NicolasTum/Tesis-Sistema-Aut-nomo-de-monitoreo-y-an-lisis-de-alarmas-para-radiobases/Análisis de datos/README.txt

Utilizar Visual Studio o similar, ejecutar en el siguiente orden:
1 - agrupar_alarmas_py
2 - analizar_alarmas.py
3 - analisis_avanzado.py
4 - detectar_eventos_compuestos.py

Los datos deben estar en data y las reglas en rules. En cambio de tener otros nombres para los archivos será necesario modificarlos en los scripts.
