NicolasTum/Tesis-Sistema-Aut-nomo-de-monitoreo-y-an-lisis-de-alarmas-para-radiobases/(threads)

Thread 2 (2025-08-04):

Envío cada una hora y cambios de estado

NicolasTum, 2025-08-04:
#include <WiFi.h>
#include <PubSubClient.h>
#include <ArduinoJson.h>
#include "NicoModBus.h"

// WiFi
const char* ssid = "HugoPacoY";
const char* password = "32950002";

// ThingsBoard
const char* tb_server = "demo.thingsboard.io";
const int tb_port = 1883;
const char* tb_token = "2dkwSGsuUQYaMfpJPUGB";

WiFiClient wifiClient;
PubSubClient mqttClient(wifiClient);

// Modbus
IPAddress moxaIP(192, 168, 1, 150);
NicoModBus mb;
bool diStates[12];
bool lastDiStates[12]; // Para comparar cambios
unsigned long lastHourlySend = 0;
const unsigned long hourlyInterval = 3600000; // 1 hora en milisegundos

void reconnectMQTT() {
  while (!mqttClient.connected()) {
    Serial.print("🔄 Conectando a ThingsBoard...");
    if (mqttClient.connect("ESP32Cliente", tb_token, NULL)) {
      Serial.println("✅ Conectado a ThingsBoard MQTT");
    } else {
      Serial.print("❌ Error MQTT: ");
      Serial.println(mqttClient.state());
      delay(2000);
    }
  }
}

void sendToThingsBoard() {
  // Armar JSON para ThingsBoard
  DynamicJsonDocument json(512);
  for (int i = 0; i < 12; i++) {
    String key = "DI" + String(i);
    json[key] = diStates[i];
  }

  char payload[256];
  serializeJson(json, payload);

  // Publicar a ThingsBoard
  if (mqttClient.publish("v1/devices/me/telemetry", payload)) {
    Serial.println("📤 Payload enviado:");
    Serial.println(payload);

    // Actualizar últimos estados enviados
    memcpy(lastDiStates, diStates, sizeof(diStates));
  } else {
    Serial.println("❌ Falló el envío a ThingsBoard");
  }
}

bool checkStateChanges() {
  for (int i = 0; i < 12; i++) {
    if (diStates[i] != lastDiStates[i]) {
      return true; // Hay cambios
    }
  }
  return false; // No hay cambios
}

void setup() {
  Serial.begin(115200);

  WiFi.begin(ssid, password);
  Serial.print("Conectando a WiFi...");
  while (WiFi.status() != WL_CONNECTED) {
    delay(500);
    Serial.print(".");
  }
  Serial.println("\n✅ WiFi conectado");

  mqttClient.setServer(tb_server, tb_port);

  // Conexión Modbus
  if (!mb.connect(moxaIP)) {
    Serial.println("❌ Falló conexión Modbus");
    while (true) delay(500);
  }

  // Inicializar últimos estados
  memset(lastDiStates, 0, sizeof(lastDiStates));
}

void loop() {
  if (!mqttClient.connected()) {
    reconnectMQTT();
  }
  mqttClient.loop();

  if (mb.readDiscreteInputs(0, diStates, 12)) {
    bool stateChanged = checkStateChanges();
    unsigned long currentMillis = millis();

    // Enviar si hay cambios o si ha pasado una hora
    if (stateChanged || (currentMillis - lastHourlySend >= hourlyInterval)) {
      sendToThingsBoard();

      if (stateChanged) {
        Serial.println("🔄 Cambio de estado detectado");
      } else {
        Serial.println("⏰ Envío periódico cada hora");
      }

      lastHourlySend = currentMillis;
    }
  } else {
    Serial.println("❌ Falló lectura Modbus, intentando reconexión...");
    mb.disconnect();
    delay(1000);
    mb.connect(moxaIP);
  }

  delay(100); // Pequeño delay para evitar saturación
}

Thread 5 (2025-09-16):

Sensors final

NicolasTum, 2025-09-16:
#include <WiFi.h>
#include <PubSubClient.h>
#include <ArduinoJson.h>
#include "NicoModBus.h"
#include <math.h>
#include <limits.h>

// ===== WiFi =====
const char* ssid     = "HugoPacoY";
const char* password = "32950002";

// ===== ThingsBoard (MQTT) =====
const char* tb_server = "demo.thingsboard.io";
const int   tb_port   = 1883;
const char* tb_token  = "2dkwSGsuUQYaMfpJPUGB";

WiFiClient   wifiClient;
PubSubClient mqttClient(wifiClient);

// ===== Modbus (MOXA) =====
IPAddress moxaIP(192, 168, 1, 150);

NicoModBus mb;
bool diStates[12];
bool lastDiStates[12];

// ===== Pines =====
const int PIN_LM35  = 35;   // ADC LM35
const int PIN_CT    = 34;   // ADC CT

// ===== Telemetría =====
unsigned long lastHourlySend = 0;
const unsigned long hourlyInterval = 3600000UL;  // 1 hora

// ===== Temperatura (LM35) =====
const int   LM_NUM_SAMPLES = 32;
const float LM_EMA_ALPHA   = 0.20f;
float ema_mV = 0.0f;
float TEMP_GAIN    = 1.000f;
float TEMP_OFFSETC = 0.0f;

float g_TempC     = 0.0f;
int   g_TempC_int = 0;
int   lastSent_TempC_int = INT_MIN;

// ===== Corriente (CT) + Funciona =====
// Calibración/escala
const float AMPS_PER_V = 100.0f;    // 100 A/V (CT 100A + burden 20Ω ≈ 1V @ 100A)
float K_GAIN = 2.0f;                // ajuste fino de ganancia (tu valor actual)

// (si querés potencia real, PF_ASSUMED)
const float LINE_V_RMS = 230.0f;
float PF_ASSUMED = 1.0f;

// Baseline y filtros
const float VRMS0_FIXED     = 0.050f;  // 50 mV en vacío parámetro para subir el humbral de lo que se considera cero
const float DEADBAND_MIN_V  = (0.20f * VRMS0_FIXED > 0.003f) ? (0.20f * VRMS0_FIXED) : 0.003f;
const float EMA_ALPHA_CT    = 0.25f;
float ema_Vrms_corr         = 0.0f;
float last_block_Vrms_corr  = 0.0f;
const float DROP_RESET      = 0.35f;

// ADC
const float VFS   = 3.3f;
const float SCALE = VFS / 4095.0f;

// Umbral de “cero” para congruencia Funciona/I
const float ZERO_EPS_A      = 0.50f;   // ≤ 0.50 A se considera 0 y Funciona=FALSE

// Reporte y triggers usando corriente REAL
const float SEND_DELTA_IRMS_A = 5.0f;  // ΔI ≥ 5 A (corriente real, no cuantizada)

float g_Irms_A        = 0.0f;   // EMA real (A)
float g_Irms_sent_A   = 0.0f;   // valor enviado (0.0 si ≤ ZERO_EPS_A)
float lastSent_Irms_A = NAN;    // para ΔI
bool  funciona_flag   = false;  // derivado de Irms_A

// ===== Helpers =====
void reconnectMQTT() {
  while (!mqttClient.connected()) {
    Serial.print("🔄 Conectando a ThingsBoard...");
    if (mqttClient.connect("ESP32Cliente", tb_token, NULL)) {
      Serial.println("✅ Conectado");
    } else {
      Serial.print("❌ MQTT state="); Serial.println(mqttClient.state());
      delay(2000);
    }
  }
}

bool checkDIChangesOnly() {
  for (int i = 0; i < 12; i++) if (diStates[i] != lastDiStates[i]) return true;
  return false;
}

// ==== LM35 ==== Medidor de temperatura
uint32_t read_mV_avg(int pin, int n) {
  uint32_t acc=0;
  for (int i=0;i<n;i++) {
    acc += analogReadMilliVolts(pin);
    if ((i & 0x0F) == 0) mqttClient.loop();
    delayMicroseconds(200);
  }
  return acc/(uint32_t)n;
}
void measureLM35() {
  uint32_t mv = read_mV_avg(PIN_LM35, LM_NUM_SAMPLES);
  ema_mV = (1.0f - LM_EMA_ALPHA) * ema_mV + LM_EMA_ALPHA * (float)mv;
  g_TempC = TEMP_GAIN * (ema_mV / 10.0f) + TEMP_OFFSETC;
  g_TempC_int = (int)roundf(g_TempC);
}

// ==== CT ====
static float medirVrms_AC(uint32_t N, uint32_t sample_delay_us) {
  // 1) media DC
  uint64_t sum = 0;
  for (uint32_t i = 0; i < N; i++) { sum += (uint32_t)analogRead(PIN_CT); delayMicroseconds(sample_delay_us); }
  float mean_counts = (float)sum / (float)N;

  // 2) energía AC centrada
  uint64_t sumsq = 0;
  int minv = 4095, maxv = 0;
  for (uint32_t i = 0; i < N; i++) {
    int r = analogRead(PIN_CT);
    int centered = (int)((float)r - mean_counts);
    sumsq += (int64_t)centered * (int64_t)centered;
    if (r < minv) minv = r; if (r > maxv) maxv = r;
    delayMicroseconds(sample_delay_us);
  }

  // clipping simple (no devolvemos nada especial, sólo aviso por serie)
  if (minv <= 8 || maxv >= 4087) {
    Serial.println("⚠ CLIP detectado, bloque descartado");
    return NAN;
  }

  return sqrtf((float)sumsq / (float)N) * SCALE;
}

void computeCT() {
  // Ventana múltiplo de 50 Hz
  const float  Ts_us_nom = 80.0f;
  const float  Fs_est    = 1e6f / Ts_us_nom;
  uint32_t samples_per_cycle = (uint32_t)(Fs_est * 0.020f + 0.5f);
  if (samples_per_cycle < 200) samples_per_cycle = 200;

  const uint32_t N_base = 5000;
  uint32_t N = (N_base / samples_per_cycle) * samples_per_cycle;
  if (N < samples_per_cycle * 10) N = samples_per_cycle * 10;
  const uint32_t du = (uint32_t)Ts_us_nom;

  // Vrms AC medido
  float Vrms_AC = medirVrms_AC(N, du);
  if (isnan(Vrms_AC)) return; // bloque descartado por clip

  // Corrección de baseline (cuadratura)
  float Vrms_corr = (Vrms_AC > VRMS0_FIXED)
                  ? sqrtf(Vrms_AC*Vrms_AC - VRMS0_FIXED*VRMS0_FIXED)
                  : 0.0f;

  // Deadband mínimo
  if (Vrms_corr < DEADBAND_MIN_V) Vrms_corr = 0.0f;

  // Reset EMA si cae mucho
  if (last_block_Vrms_corr > 0.0f) {
    float drop = (last_block_Vrms_corr - Vrms_corr) / (last_block_Vrms_corr + 1e-9f);
    if (drop > DROP_RESET) ema_Vrms_corr = Vrms_corr;
  }

  // EMA
  ema_Vrms_corr = (1.0f - EMA_ALPHA_CT) * ema_Vrms_corr + EMA_ALPHA_CT * Vrms_corr;
  last_block_Vrms_corr = Vrms_corr;

  // Corriente REAL (A)
  g_Irms_A = ema_Vrms_corr * AMPS_PER_V * K_GAIN;

  // Funciona y valor a enviar CONGRUENTES con el cero
  funciona_flag  = (g_Irms_A > ZERO_EPS_A);
  g_Irms_sent_A  = funciona_flag ? g_Irms_A : 0.0f;

  // (Debug opcional)
  static unsigned long dbg_t = 0;
  if (millis() - dbg_t > 2000) {
    dbg_t = millis();
    Serial.print("Vrms_corr=");  Serial.print(ema_Vrms_corr, 5);
    Serial.print(" V  | Irms="); Serial.print(g_Irms_A, 2);
    Serial.print(" A  | Funciona="); Serial.print(funciona_flag ? "ON":"off");
  }
}

// ==== ThingsBoard ====
bool sendToThingsBoard() {
  DynamicJsonDocument json(1024);
  // DI del MOXA
  for (int i = 0; i < 12; i++) {
    String key = "DI" + String(i);
    json[key] = diStates[i];
  }
  // Analógicos y flags
  json["TempC"]     = g_TempC_int;
  json["Irms_A"]    = g_Irms_sent_A;   // real; 0.0 si ≤ ZERO_EPS_A
  json["Funciona"]  = funciona_flag;

  char payload[768];
  size_t n = serializeJson(json, payload, sizeof(payload));
  bool ok = mqttClient.publish("v1/devices/me/telemetry", payload, n);
  if (ok) {
    Serial.println("📤 Enviado a ThingsBoard:");
    Serial.println(payload);
  } else {
    Serial.println("❌ Falló publish");
  }
  return ok;
}

void setup() {
  Serial.begin(115200);
  delay(200);

  analogReadResolution(12);
  analogSetPinAttenuation(PIN_LM35, ADC_0db);
  analogSetPinAttenuation(PIN_CT,   ADC_11db);

  WiFi.begin(ssid, password);
  Serial.print("Conectando a WiFi");
  while (WiFi.status() != WL_CONNECTED) { delay(500); Serial.print("."); }
  Serial.println("\n✅ WiFi conectado");
  Serial.print("IP: "); Serial.println(WiFi.localIP());

  mqttClient.setServer(tb_server, tb_port);
  reconnectMQTT();

  if (!mb.connect(moxaIP)) {
    Serial.println("❌ Falló conexión Modbus (se reintenta en loop)");
  }

  memset(lastDiStates, 0, sizeof(lastDiStates));
  lastHourlySend = millis();

  // Inicial EMA LM35
  ema_mV = (float)analogReadMilliVolts(PIN_LM35);
  g_TempC_int = (int)roundf(TEMP_GAIN * (ema_mV / 10.0f) + TEMP_OFFSETC);

  // Inicial corriente
  lastSent_Irms_A   = NAN;
  lastSent_TempC_int = INT_MIN;

  Serial.print("CT params -> VRMS0_FIXED="); Serial.print(VRMS0_FIXED, 3);
  Serial.print(" V, ZERO_EPS_A="); Serial.print(ZERO_EPS_A, 2);
  Serial.print(" A, K_GAIN="); Serial.println(K_GAIN, 2);
}

void loop() {
  if (!mqttClient.connected()) reconnectMQTT();
  mqttClient.loop();

  // 1) DI por Modbus
  if (!mb.readDiscreteInputs(0, diStates, 12)) {
    Serial.println("❌ Modbus read falló, reconectando...");
    mb.disconnect(); delay(200); mb.connect(moxaIP);
  }

  // 2) Medidas
  measureLM35();
  computeCT();

  // 3) Lógica de envío
  unsigned long now = millis();
  bool timeForHourly = (now - lastHourlySend >= hourlyInterval);
  bool diChanged     = checkDIChangesOnly();

  bool tempBigChange = false;
  if (lastSent_TempC_int == INT_MIN || abs(g_TempC_int - lastSent_TempC_int) >= 5)
    tempBigChange = true;

  // ΔI con corriente REAL
  bool currentBigChange = false;
  if (isnan(lastSent_Irms_A) || fabsf(g_Irms_A - lastSent_Irms_A) >= SEND_DELTA_IRMS_A)
    currentBigChange = true;

  // Cruce del umbral de cero (cambia Funciona)
  bool lastWasZero = (!isnan(lastSent_Irms_A) && lastSent_Irms_A <= ZERO_EPS_A);
  bool nowIsZero  = (g_Irms_A <= ZERO_EPS_A);
  bool currentZeroEdge = (isnan(lastSent_Irms_A) ? nowIsZero : (lastWasZero != nowIsZero));

  if (diChanged || tempBigChange || currentBigChange || currentZeroEdge || timeForHourly) {
    if (timeForHourly) { lastHourlySend = now; Serial.println("⏰ Keepalive 1h"); }
    if (diChanged)          Serial.println("🔄 Cambio de estado (DI)");
    if (tempBigChange)      Serial.println("📈 ΔTemp ≥ 5 °C");
    if (currentBigChange)   Serial.println("⚡ ΔI ≥ 2 A (corriente real)");
    if (currentZeroEdge)    Serial.println(nowIsZero ? "🛑 I→0 A (Funciona=FALSE)"
                                                     : "▶ I>0 A (Funciona=TRUE)");

    if (sendToThingsBoard()) {
      // Actualizar “últimos enviados” DESPUÉS del publish exitoso
      lastSent_Irms_A    = g_Irms_A;
      lastSent_TempC_int = g_TempC_int;
      memcpy(lastDiStates, diStates, sizeof(diStates));
    }
  }

  delay(50);
}
