NicolasTum/Tesis-Sistema-Aut-nomo-de-monitoreo-y-an-lisis-de-alarmas-para-radiobases/(list of files, drawings)

Other design files:
TesisV1.pdsprj
